AGYTgit/Arduino_Game_Board/USB backup/Obrázky/1.jpg

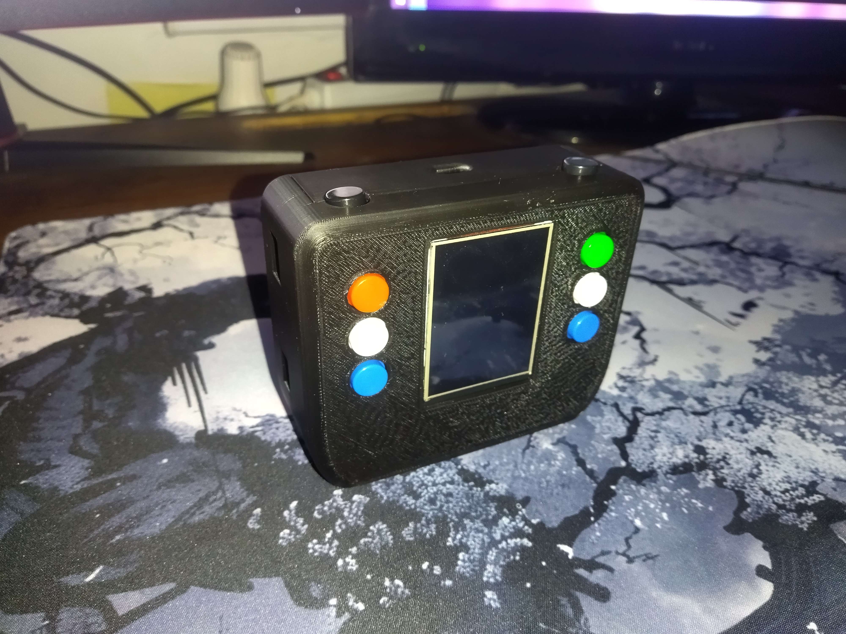
USB backup/Obrázky/1.jpg
