AGYTgit/Arduino_Game_Board/USB backup/Obrázky/3.jpg

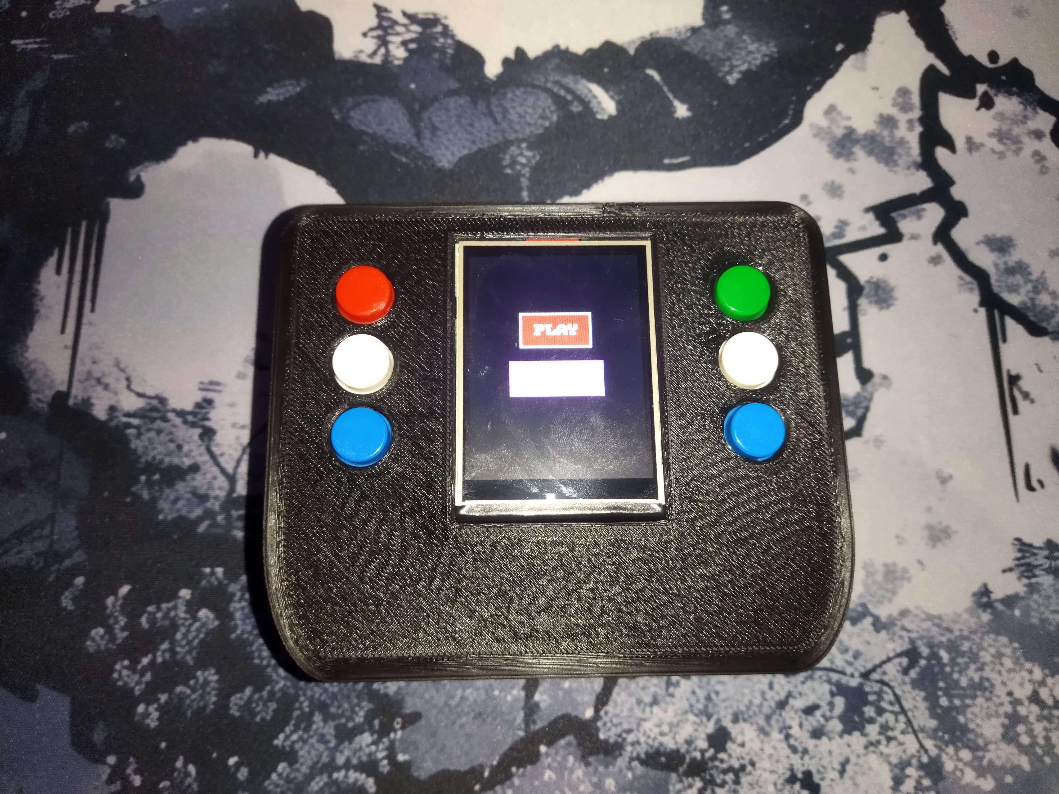
USB backup/Obrázky/3.jpg
