AGYTgit/Arduino_Game_Board/USB backup/IVCI-Borbély-Arduino Herná Konzola.pptx

## Arduino Herná Konzola

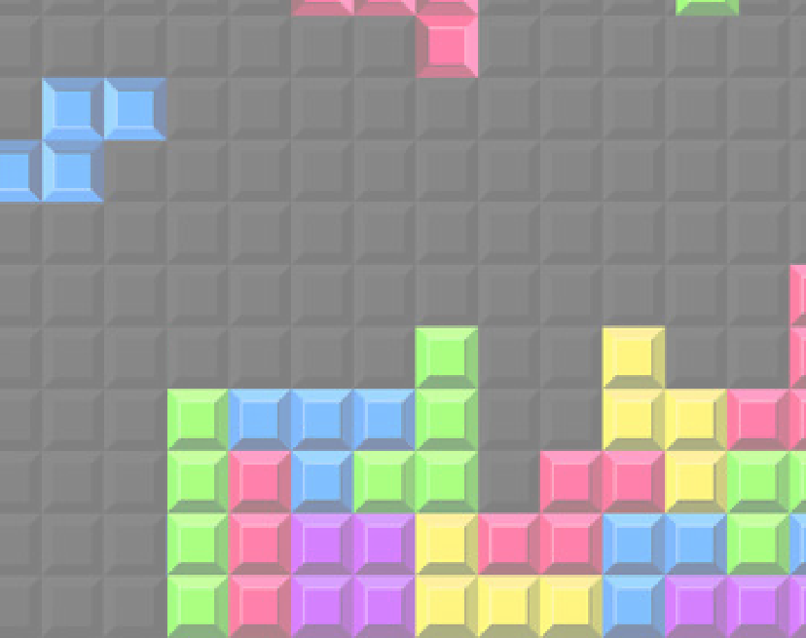
[picture p3: figure]

- Meno a priezvisko : Norbu Borbély
- Vedúci práce : Ing. Peter Remiš
- Školský rok : 2024/25
- Trieda : 4.CI

## Hlavné ciele

- Navrhnúť a implementovať funkčnú verziu hry Tetris na platforme Arduino Nano.
- Vytvoriť vlastné softvérové knižnice s výnimkou knižnice Arduino.h.
- Navrhnúť PCB pre daný projekt.
- Navrhnúť 3D model ako obal konzoly.

## Vedľajšie ciele

- Prispôsobiť vizuálny vzhľad hier a používateľského rozhrania.
- Rozšíriť projekt o ďalšie hry.
- Pridať spôsob nabíjania konzole.

## Schéma zapojenia

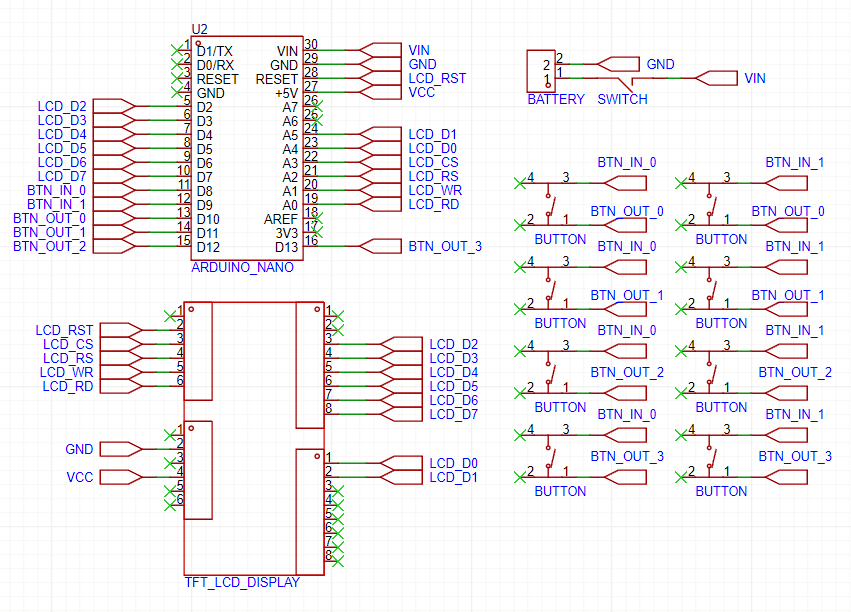
[picture p4: figure]

## Implementácia knižnice ST7789V

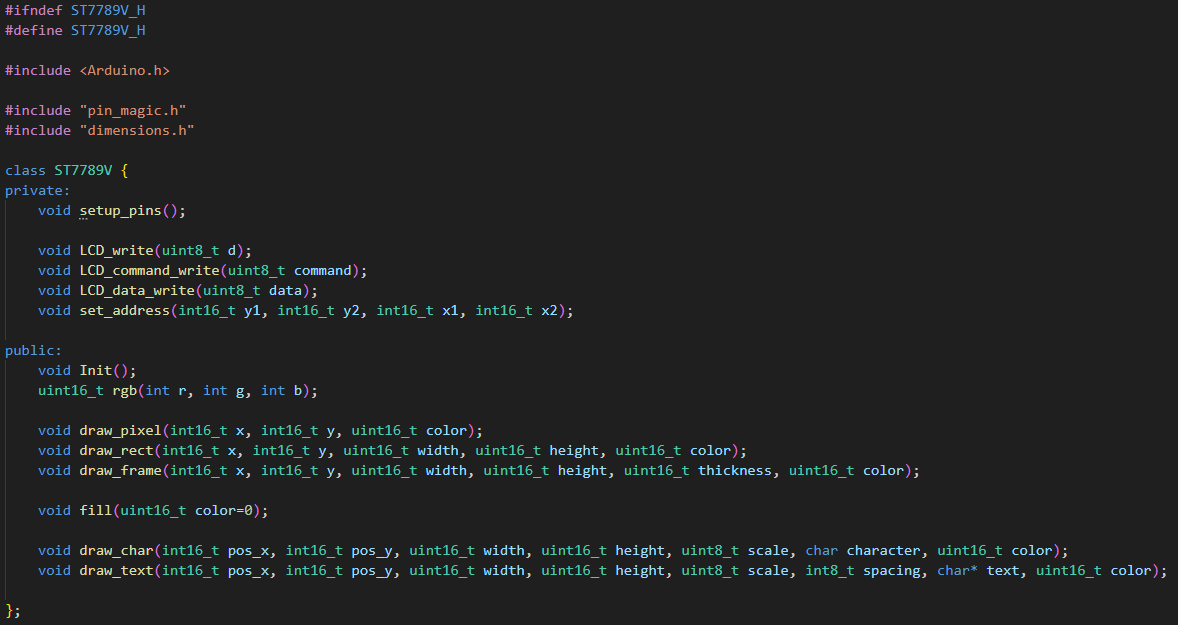
[picture p5: figure]
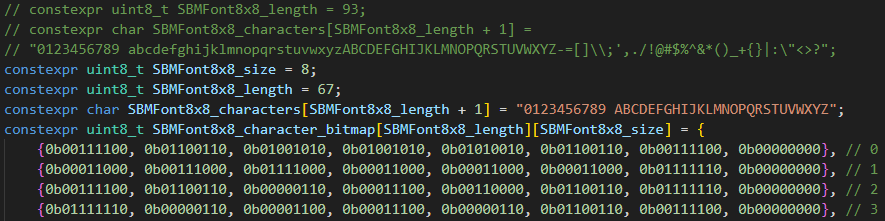
[picture p6: figure]

## Slide 6

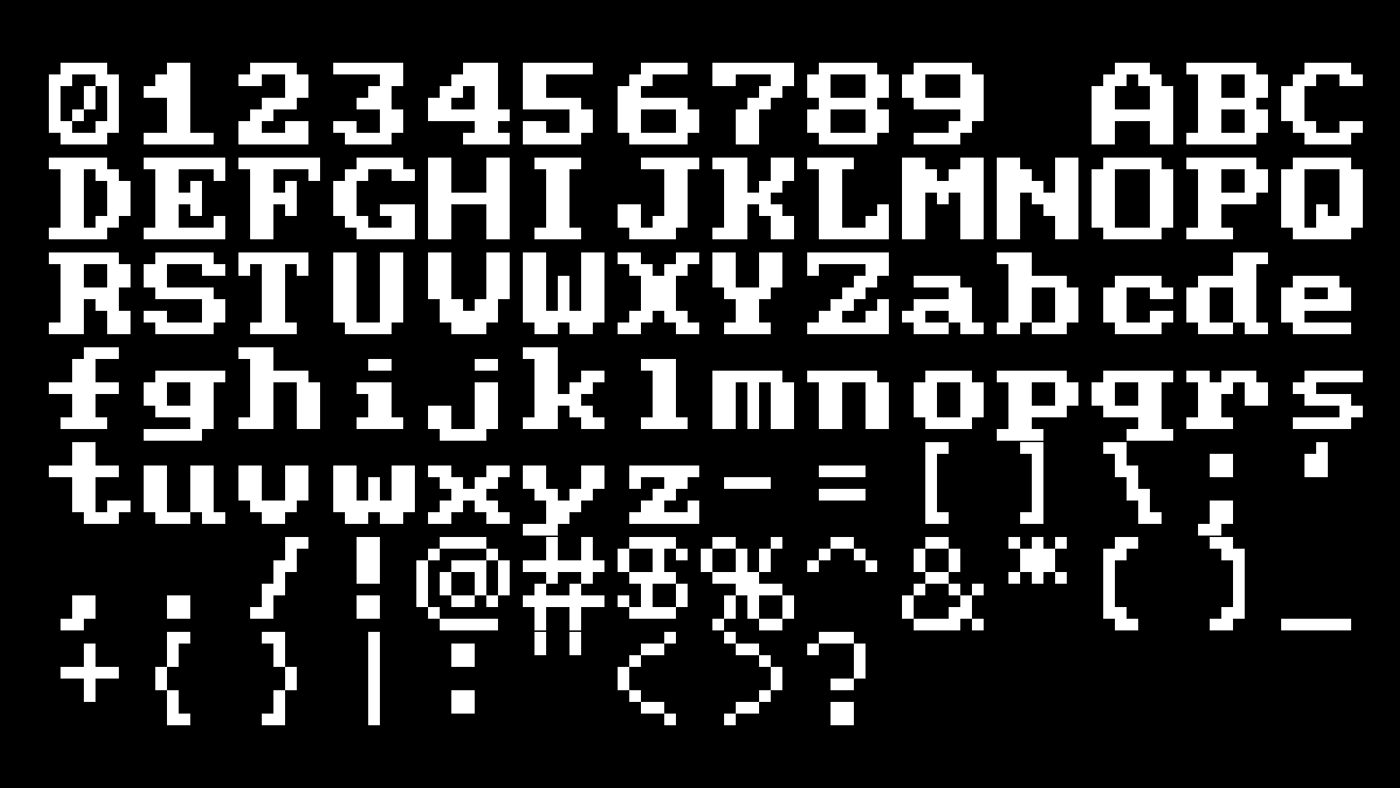
[picture p7: figure]
SBMFont

## Slide 7

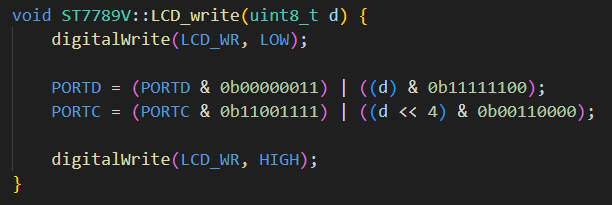
[picture p8: figure]
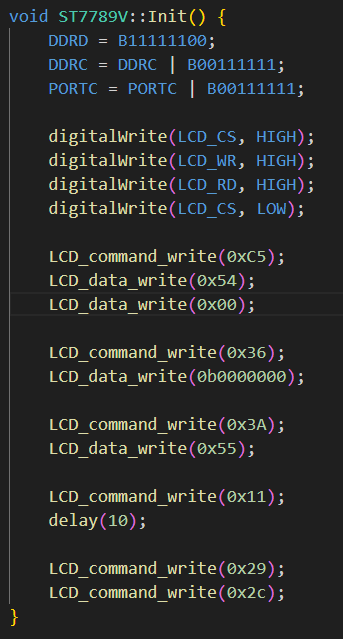
[picture p9: figure]
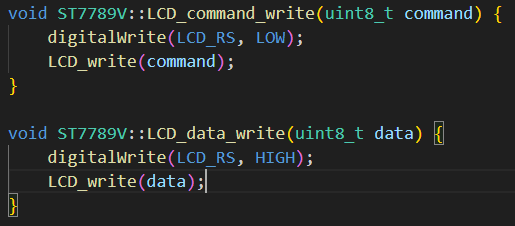
[picture p10: figure]
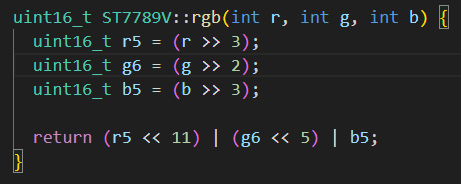
[picture p11: figure]

## Implementácia hry Tetris

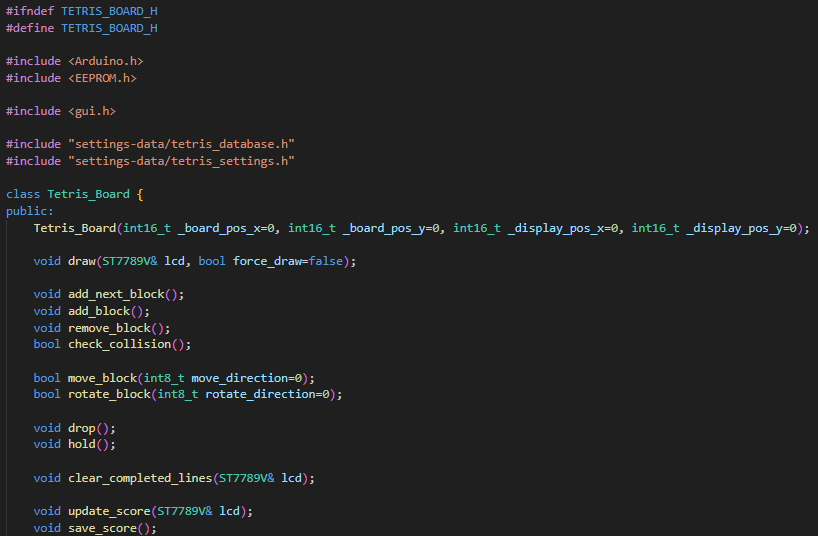
[picture p12: figure]
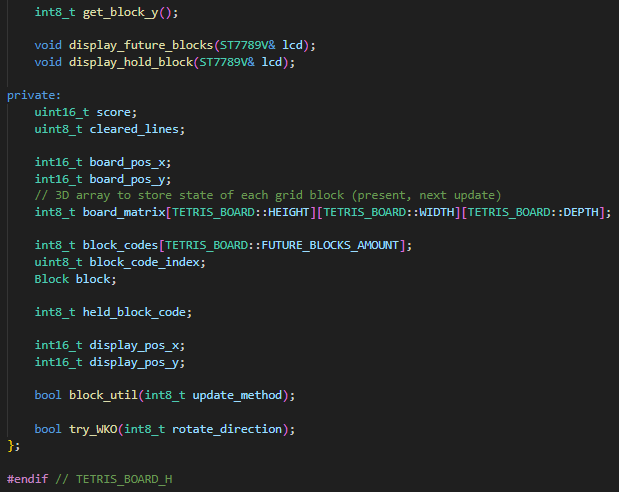
[picture p13: figure]

## Tetris databáza

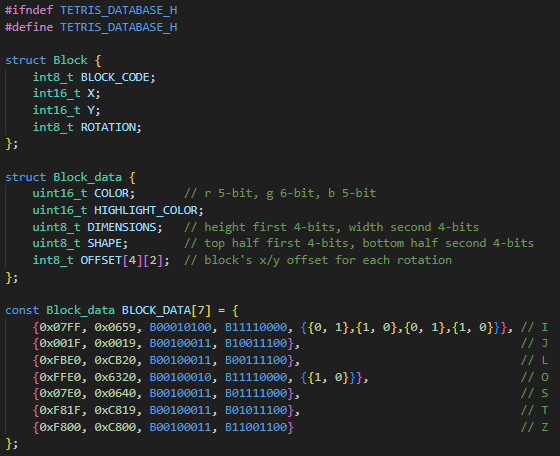
[picture p14: figure]
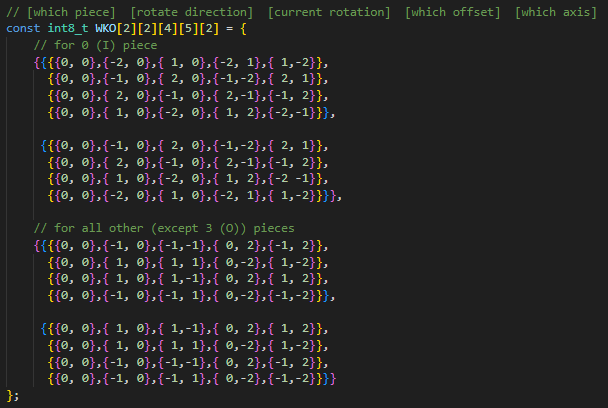
[picture p15: figure]

## Implementácia hry Minesweeper

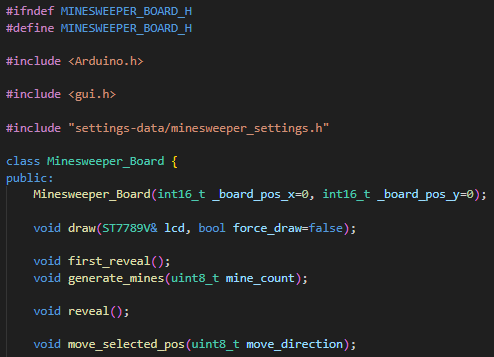
[picture p16: figure]
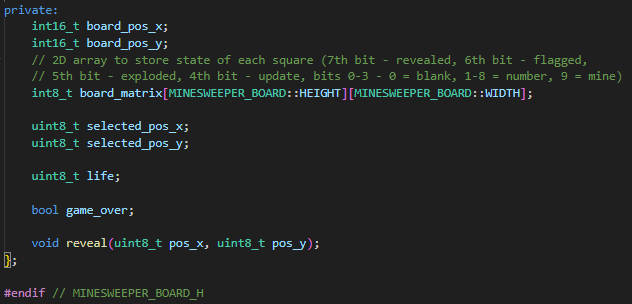
[picture p17: figure]

## Slide 11

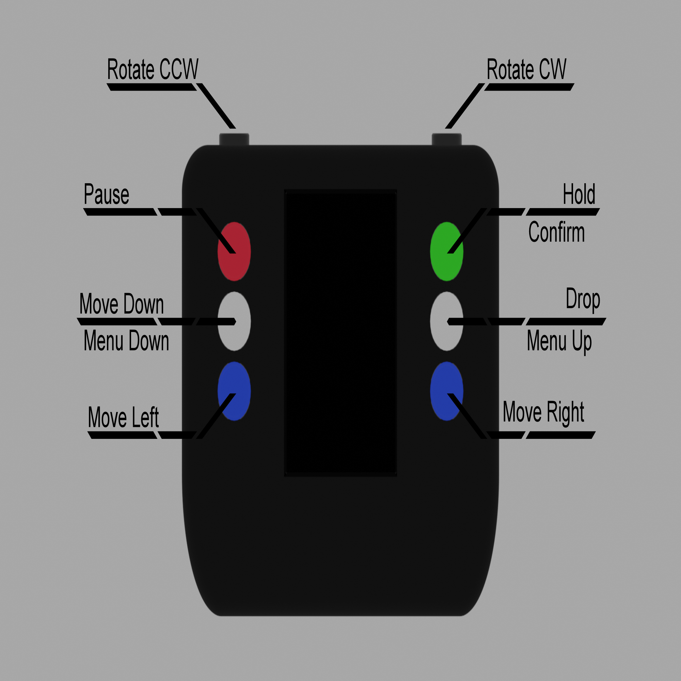
[picture p18: figure]
drawing

## Priestor na otázky
