AGYTgit/Arduino_Game_Board/misc/game_ui_design.png

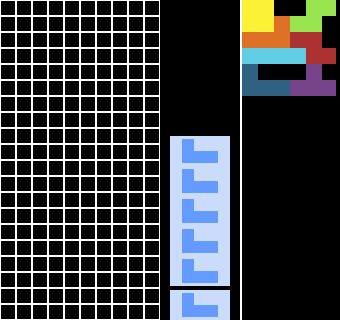
misc/game_ui_design.png
