AGYTgit/Arduino_Game_Board/model/untitled.png

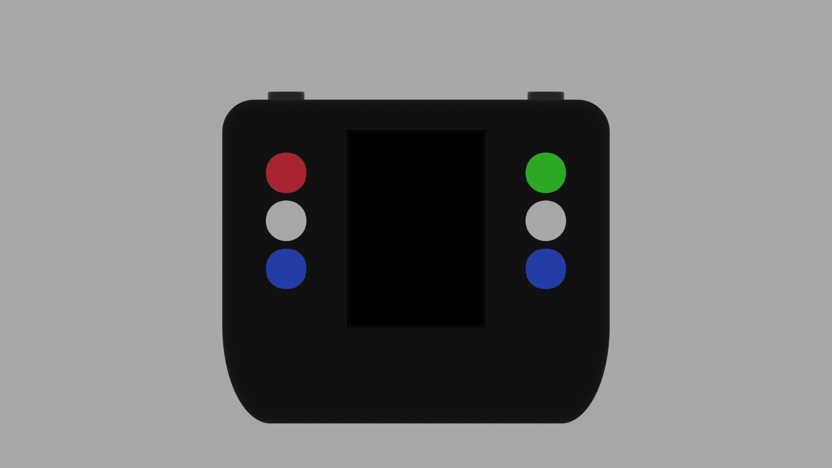
model/untitled.png
