AGYTgit/Arduino_Game_Board/USB backup/Obrázky/2.jpg

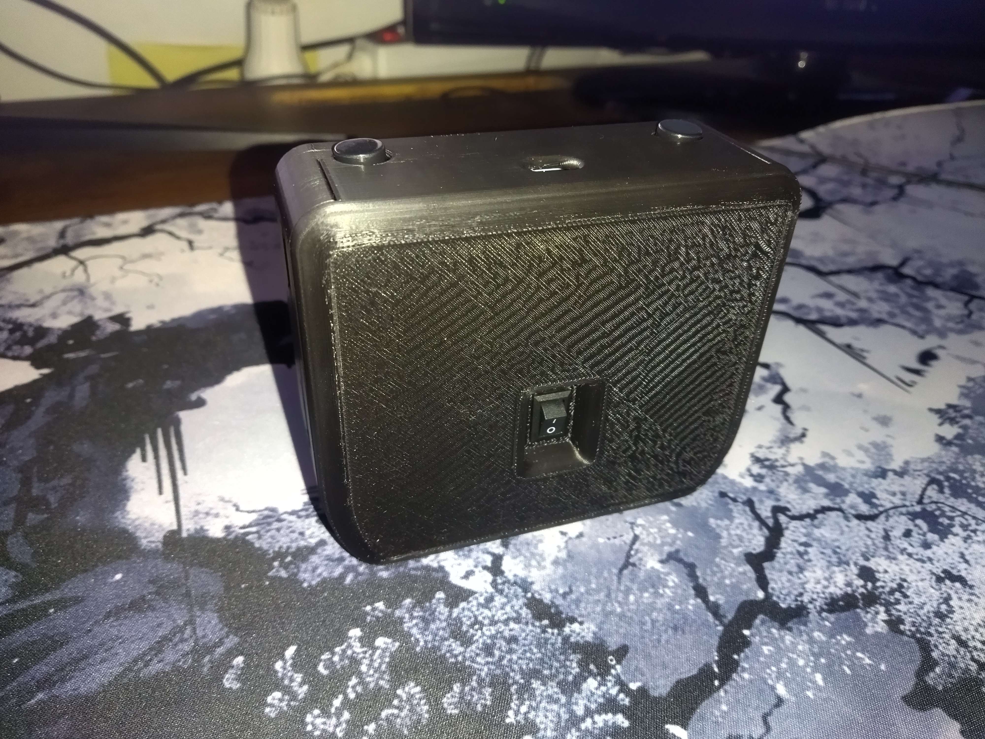
USB backup/Obrázky/2.jpg
