AGYTgit/Arduino_Game_Board/USB backup/Obrázky/4.jpg

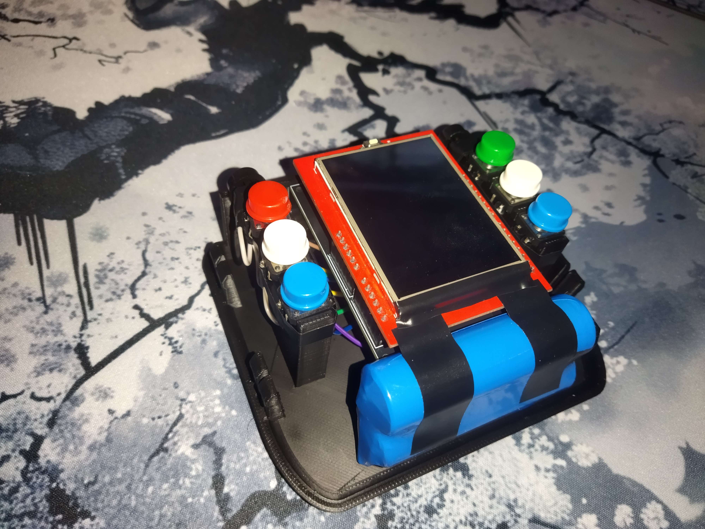
USB backup/Obrázky/4.jpg
