AGYTgit/Arduino_Game_Board/USB backup/Obrázky/5.jpg

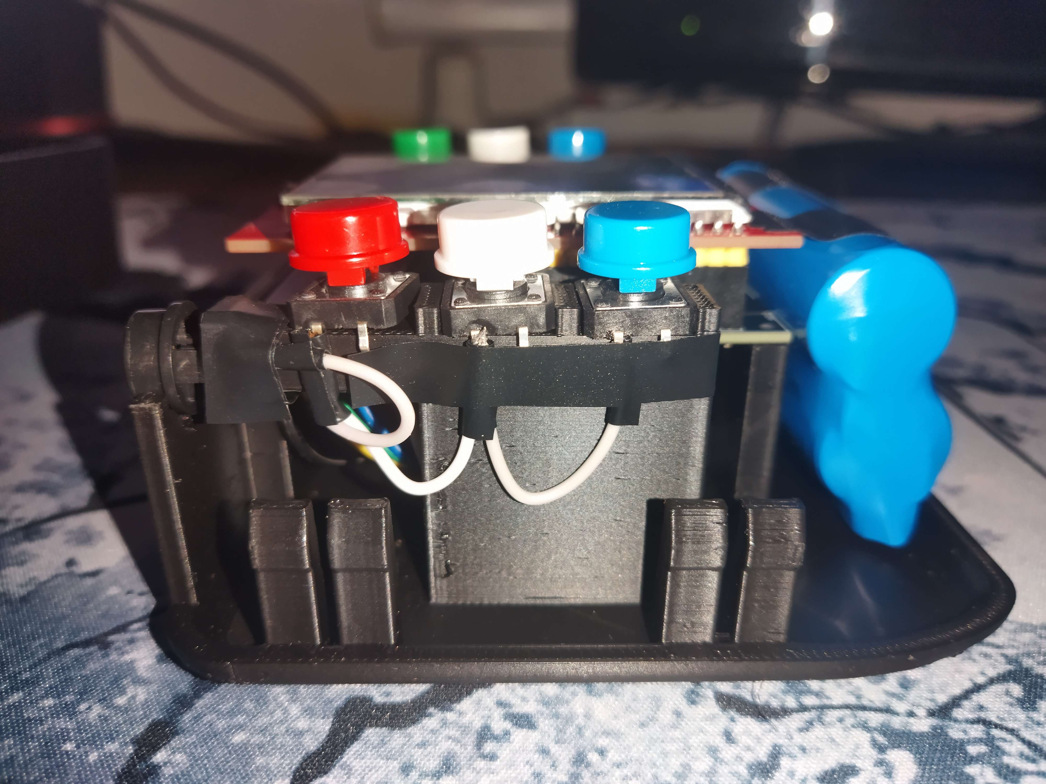
USB backup/Obrázky/5.jpg
