AGYTgit/Arduino_Game_Board/model/printReady/back.stl

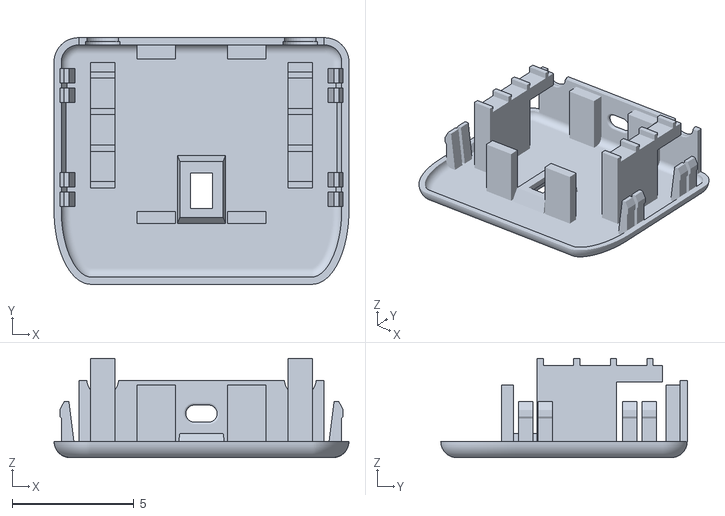
[picture p34: CAD file, 2025-03-30]
model/printReady/back.stl
12.1 x 10.1 x 4.08
