AGYTgit/Arduino_Game_Board/model/printReady/front.stl

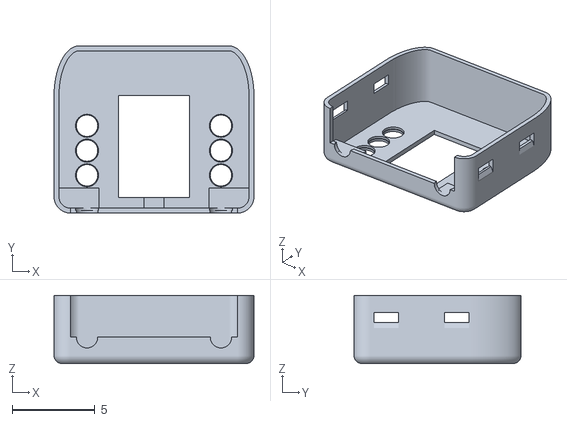
[picture p35: CAD file, 2025-03-30]
model/printReady/front.stl
12.1 x 10.1 x 4.13
