AGYTgit/Arduino_Game_Board/(list of files, cad)

Other CAD files:
model/printReady/back.blend
model/printReady/front.blend
