AGYTgit/Arduino_Game_Board/(list of files, drawings)

Other design files:
misc/ProPrj_AGB_2024-12-26.epro
