AGYTgit/Arduino_Game_Board/(commit log)

2024-06-01 Version 0.1
    Swapped to PlatformIO
    [main.cpp]
2024-06-18 button test
    3x3 button matrix scanning test
2024-06-19 cable test
    new M-M cables not working
    [main.cpp]
2024-06-22 button grid scanning (working)
2024-06-23 Version 0.2
    implemented move_block and rotate_block int Board
2024-06-26 Version 0.2.2
    fixed collision system and implemented it in rotate_block(), also reformated the code to use switch where possible, and removed unnecessary nesting
    [main.cpp]
2024-06-26 Version 0.2.3
    implemented WKO (wall kick offset) and started remaking restrictions for not moving outside game board with using offset for each rotation of each piece
2024-06-28 Version 0.3
    Fixed blocks going outside of board, reworked offset and WKO, combined add_block, remove_block and check_collision into one update_block for less redundanci, added a simple system for adding new blocks through serial
    [main.cpp]
2024-07-23 button grid scanning 2.0 (working)
2024-08-07 Version 0.3.2
    added GUI for menu with buttons that can be selected forwards and backwards
2024-08-08 Version 0.3.4
    libraries for menu, button and button_grid
2024-08-08 Version 0.4
    WORKING menu CONTROLABLE using button_grid
2024-08-11 Version 0.4.1
    Optimized menu and button_grid
2024-08-11 Version 0.4.2
    added game_select_menu, tetris_menu and minesweeper_menu which can be swapped between each other
    [test.cpp]
2024-08-13 Version 0.4.4
    made tetris playable, also added drop block function and fixed button not working on 0x10
    [main.cpp]
2024-08-14 Version 0.4.4.1
    small fixes for drawing order and some types
    [main.cpp]
2024-08-15 Version 0.4.5
    added future blocks to board, bug when rotating from rotation 2 to rotation 3 on any block the block is moved to the right by 2, bug the first block is always 0
    [main.cpp]
2024-08-16 Version 0.5
    added future block display, fixed previous bugs
    [main.cpp]
2024-08-20 Version 0.6.1
    menu and button classes optimizations
2024-08-22 Version 0.7
    functional generation for mines and numbers in minesweeper, and drawing of board on display
2024-09-01 Version 0.7.8
    added text to buttons and numbers in minesweeper, which sometimes cause a crash
    [main.cpp]
2024-09-07 Porting to ESP32-S3-WROOM-2
2024-10-20 button checking
    functional button with occasional unintended presses and core panic'ed error when trying to use scan from button_grid
    [main.cpp, test.cpp]
2024-11-05 added 3d model
    [model.blend]
2024-11-06 multi button press (wip)
2024-12-14 fixes and pause screen
    [main.cpp, test.cpp]
2024-12-21 added easyEDA schematic
    [AGB_PCB.epro]
2024-12-26 updated PCB
    [AGB_PCB.epro, ProPrj_AGB_2024-12-26.epro]
2024-12-27 redesigned UI, fixed score and some bugs
    [main.cpp]
2025-01-16 fixed score system, new 3D model
    [model.blend]
2025-02-12 model update final
    [back.blend, back.stl, front.blend, front.stl]
2025-02-16 model update
    [back.blend, back.stl, front.blend, front.stl]
2025-03-30 print ready model
    [back.blend, back.stl, front.blend, front.stl]
2025-04-01 rebind, fixed saving score on finish
    [main.cpp]
